norioike/DTMF_module_RDM-01/obniz_sample/obniz_connection_image.JPG

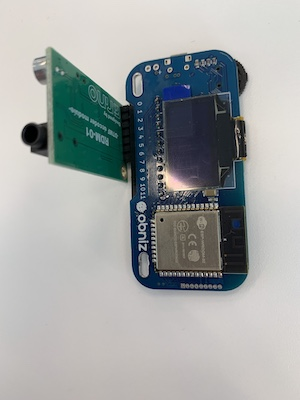
obniz_sample/obniz_connection_image.JPG
