norioike/DTMF_module_RDM-01/PCB/schematic.pdf

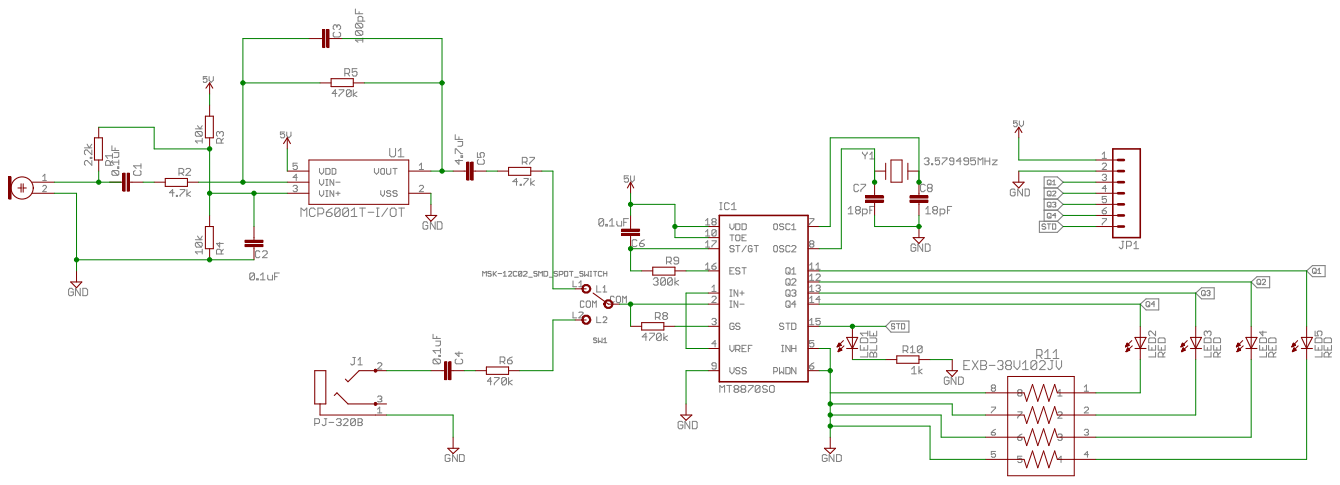
[picture p2: page 1]
