norioike/DTMF_module_RDM-01/command_list.pdf

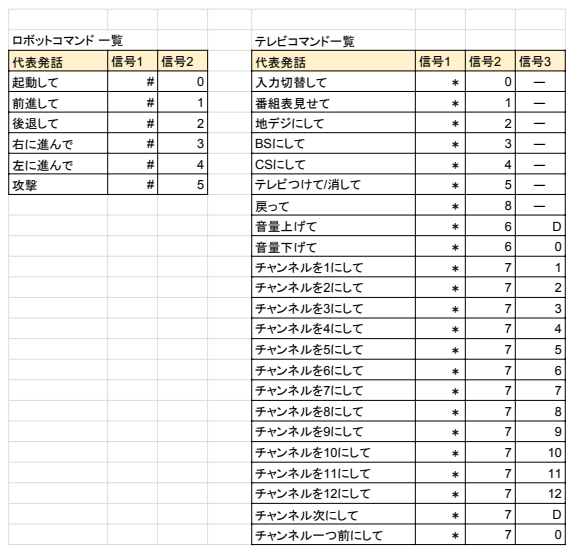
[picture p3: page 1]
ロボットコマンド 一覧; テレビコマンド一覧; 代表発話; 起動して; 入力切替して; 前進して; 番組表見せて; 後退して; 地デジにして; 右に進んで; BSにして; 左に進んで; CSにして; テレビつけて/消して

戻って | ＊ | 8 | ー
音量上げて | ＊ | 6 | D
音量下げて | ＊ | 6 | 0
チャンネルを1にして | ＊ | 7 | 1
チャンネルを2にして | ＊ | 7 | 2
チャンネルを3にして | ＊ | 7 | 3
チャンネルを4にして | ＊ | 7 | 4
チャンネルを5にして | ＊ | 7 | 5
チャンネルを6にして | ＊ | 7 | 6
チャンネルを7にして | ＊ | 7 | 7
チャンネルを8にして | ＊ | 7 | 8
チャンネルを9にして | ＊ | 7 | 9
チャンネルを10にして | ＊ | 7 | 10
チャンネルを11にして | ＊ | 7 | 11
チャンネルを12にして | ＊ | 7 | 12
チャンネル次にして | ＊ | 7 | D
チャンネル一つ前にして | ＊ | 7 | 0
