norioike/DTMF_module_RDM-01/PCB/PCB_dimension.pdf

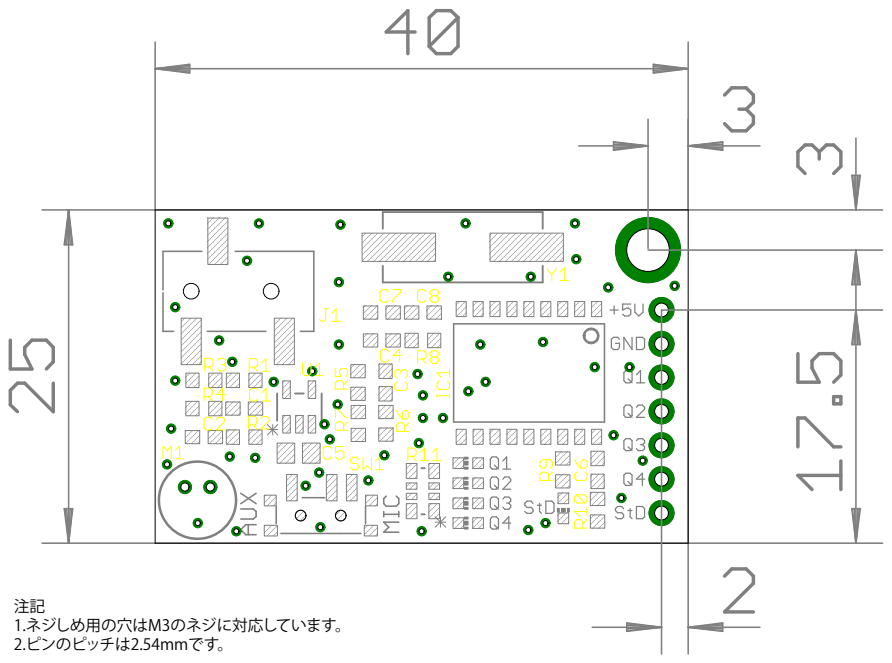
[picture p4: page 1]
注記 1.ネジしめ用の穴はM3のネジに対応しています。 2.ピンのピッチは2.54mmです。
