norioike/DTMF_module_RDM-01/(commit log)

2019-01-22 add samples and pcb data
2019-01-30 コマンドリスト追加
2019-01-31 DTMFサンプルサウンド追加
2019-02-01 音源ファイルの変更
2019-02-10 obniz サンプル追加
2019-02-16 obnizの割り込み機能を使ったコード追加
